sahangunasekara/VoiceRecorder/README.md

# VoiceRecorder
Manufacturing a simple voice recorder using ATMega 328p Microcontroller
