sahangunasekara/VoiceRecorder/(list of files, drawings)

Other design files:
Simulation/ATMEGA328P integaration.pdsprj
Simulation/FinalBuild.pdsprj
Simulation/RECnPLAY.pdsprj
